MProx/balance_bot/pcb/Layout (bottom).png

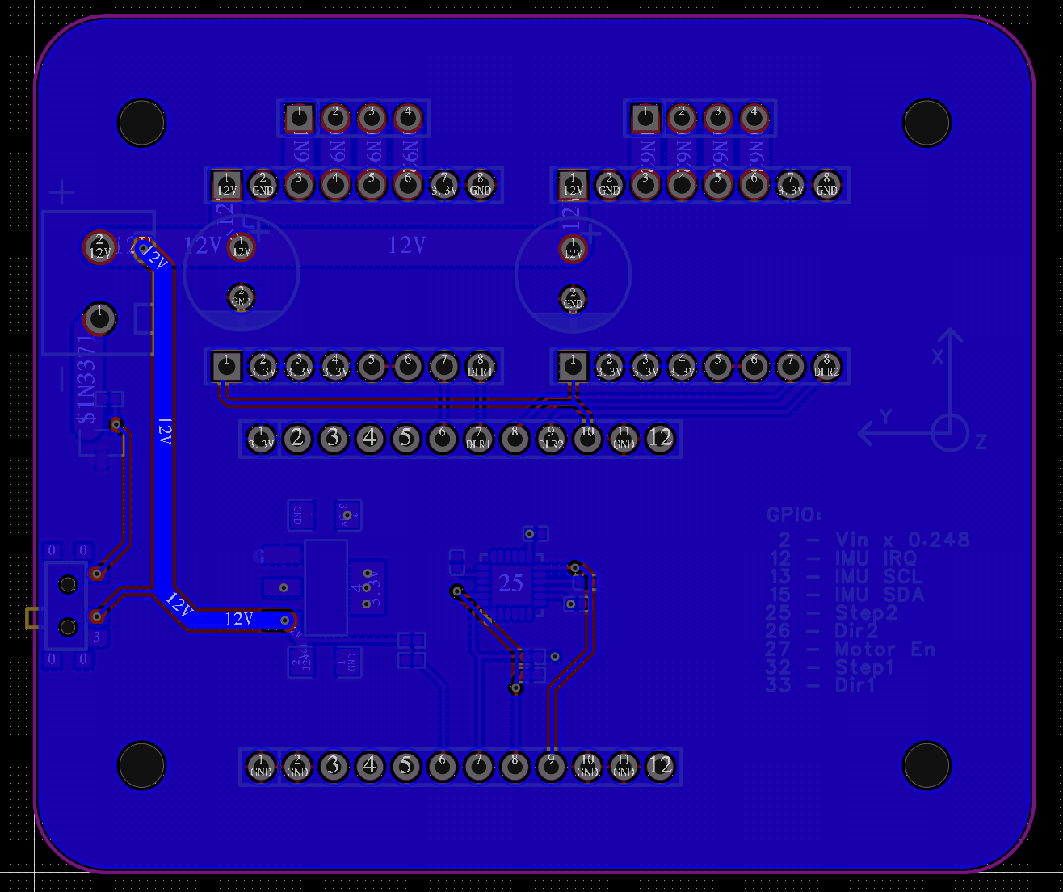
pcb/Layout (bottom).png
