MProx/balance_bot/pcb/Layout (top).png

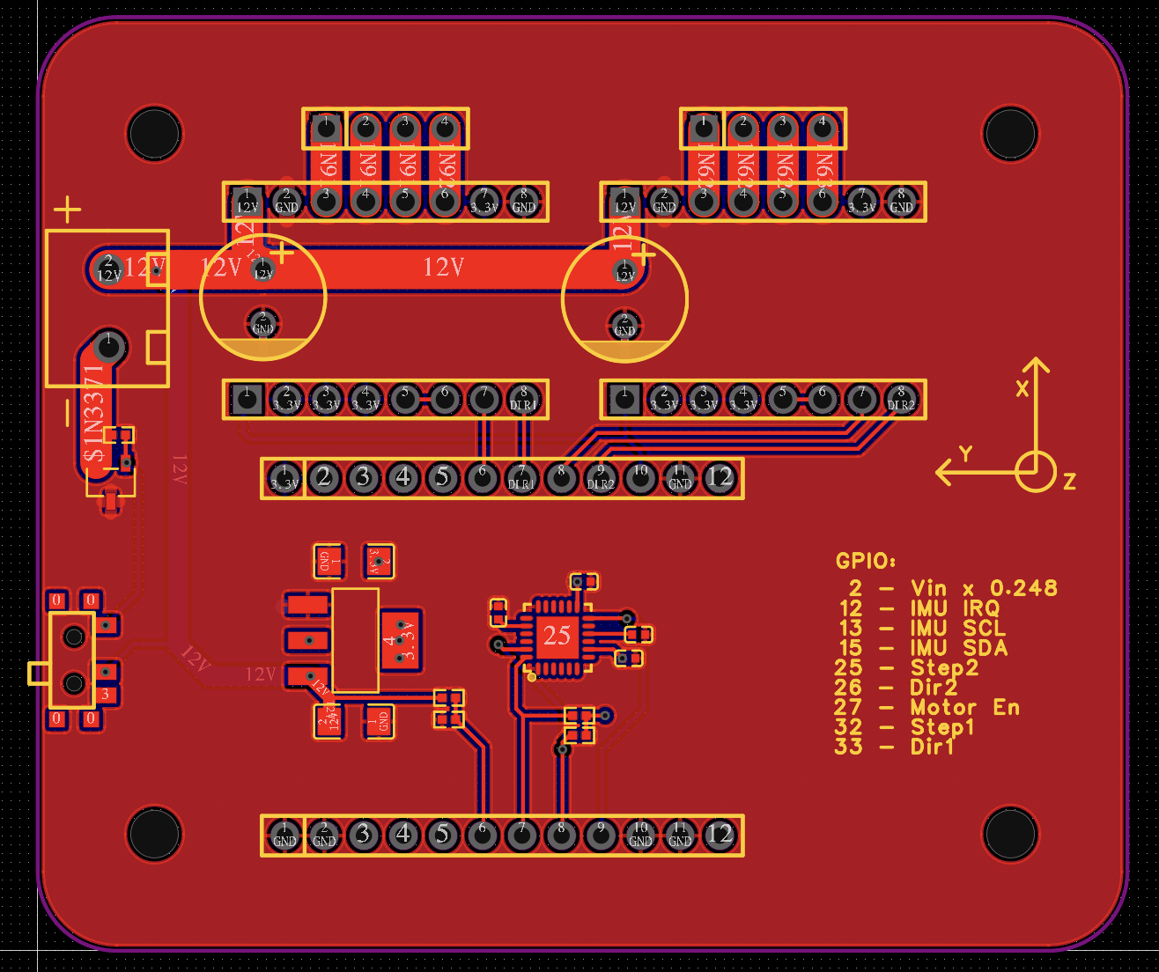
pcb/Layout (top).png
