MProx/balance_bot/pcb/Schematic.png

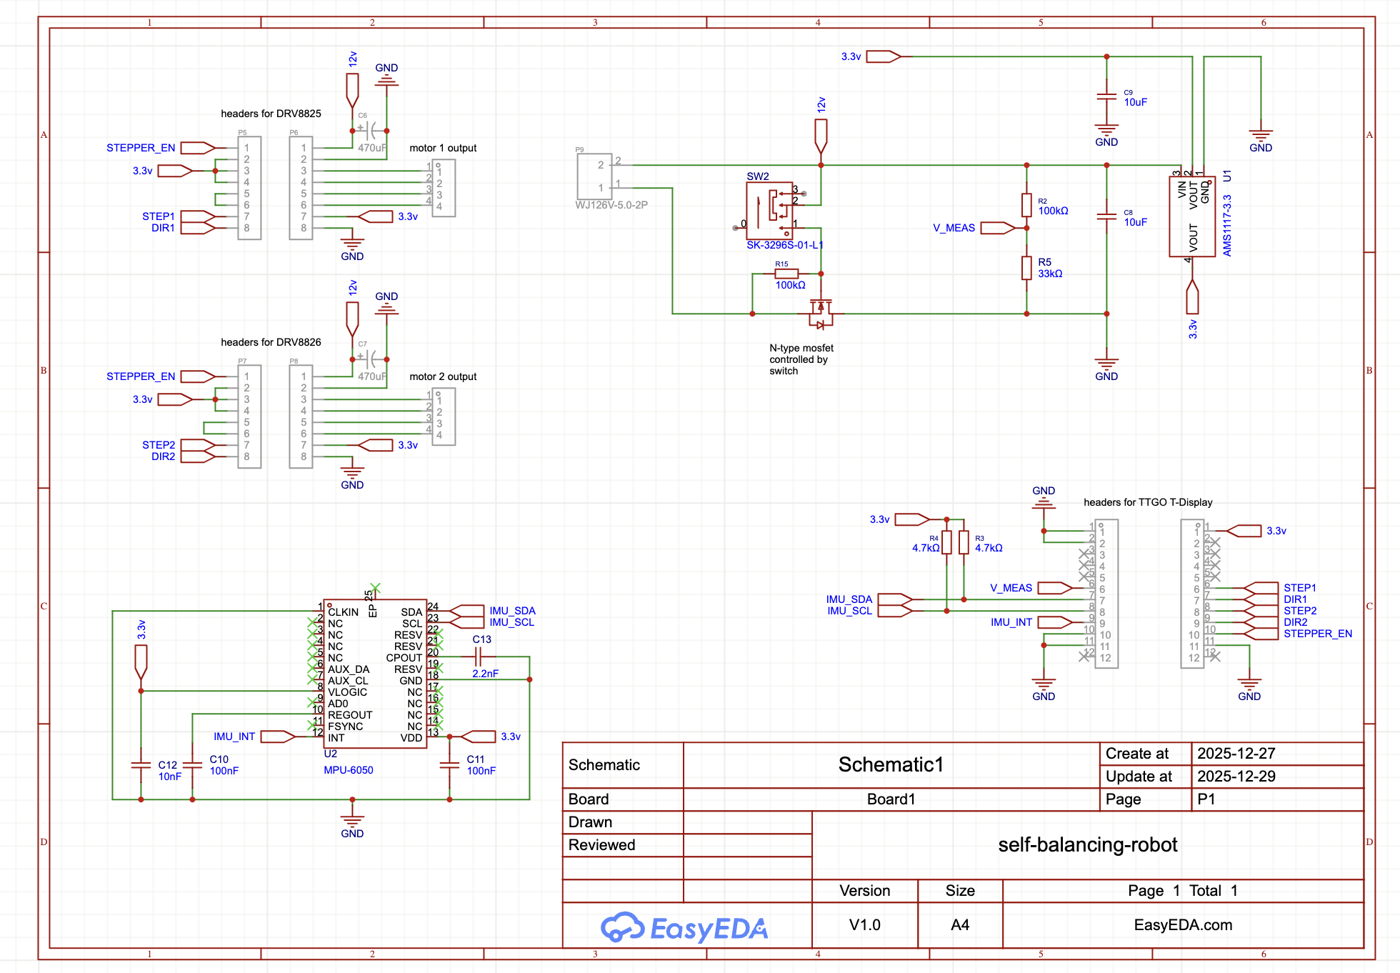
pcb/Schematic.png
