MProx/balance_bot/(list of files, drawings)

Other design files:
pcb/self-balancing-robot.eprj
