MProx/balance_bot/(commit log)

2025-12-30 Add pcb layout and schematic screenshots
2026-01-16 Use butterworth filters on IMU output
2026-01-21 Fix filters
2026-01-31 Dynamic complementary filter alpha control
